futureshocked/NodeRed-ESP32-TerrariumController/KiCad Terrarium Controller project/node-red-terrarium-controller sch v2 original.pdf

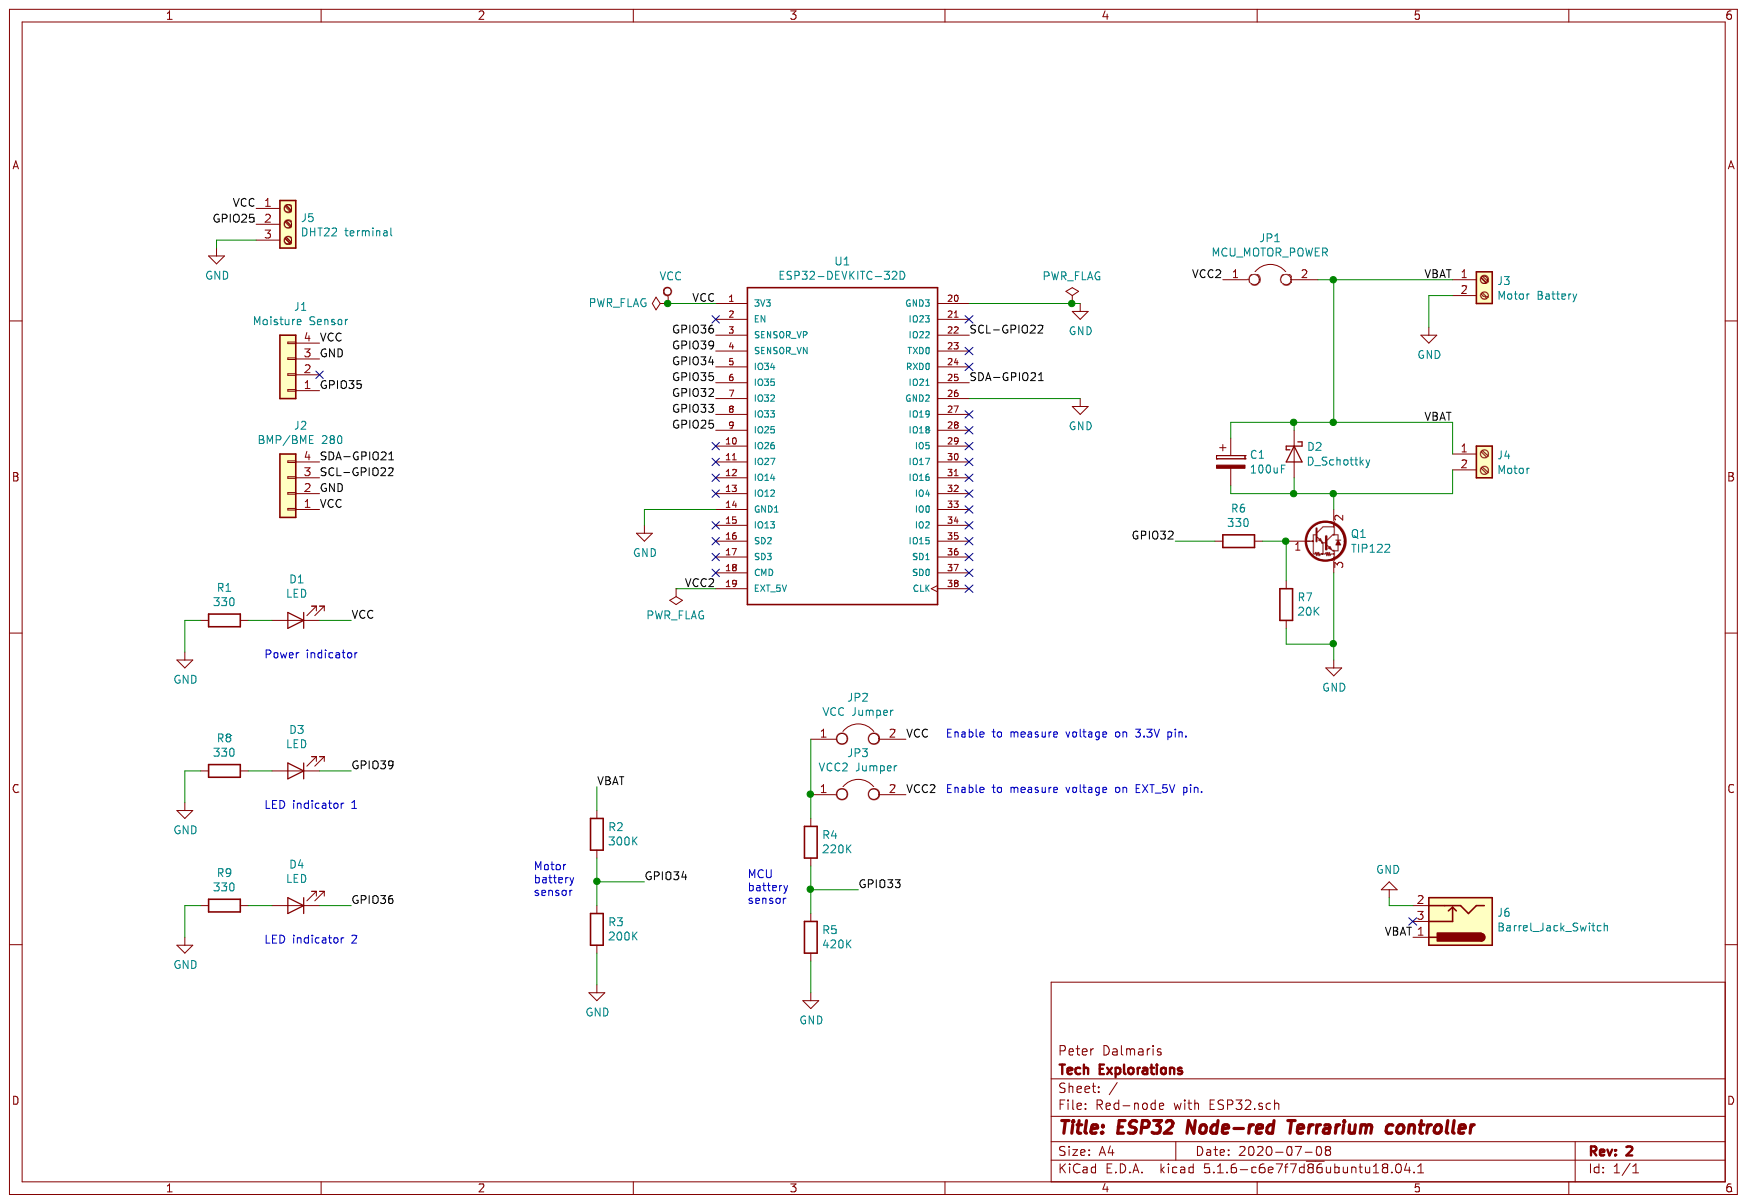
[picture p1: page 1]
