futureshocked/NodeRed-ESP32-TerrariumController/(list of files, drawings)

Other design files:
KiCad Terrarium Controller project/Red-node with ESP32.dsn
