futureshocked/NodeRed-ESP32-TerrariumController/KiCad Terrarium Controller project/Red-node with ESP32.kicad_pcb

## KiCad design KiCad Terrarium Controller project/Red-node with ESP32.kicad_pcb (2025-11-27)

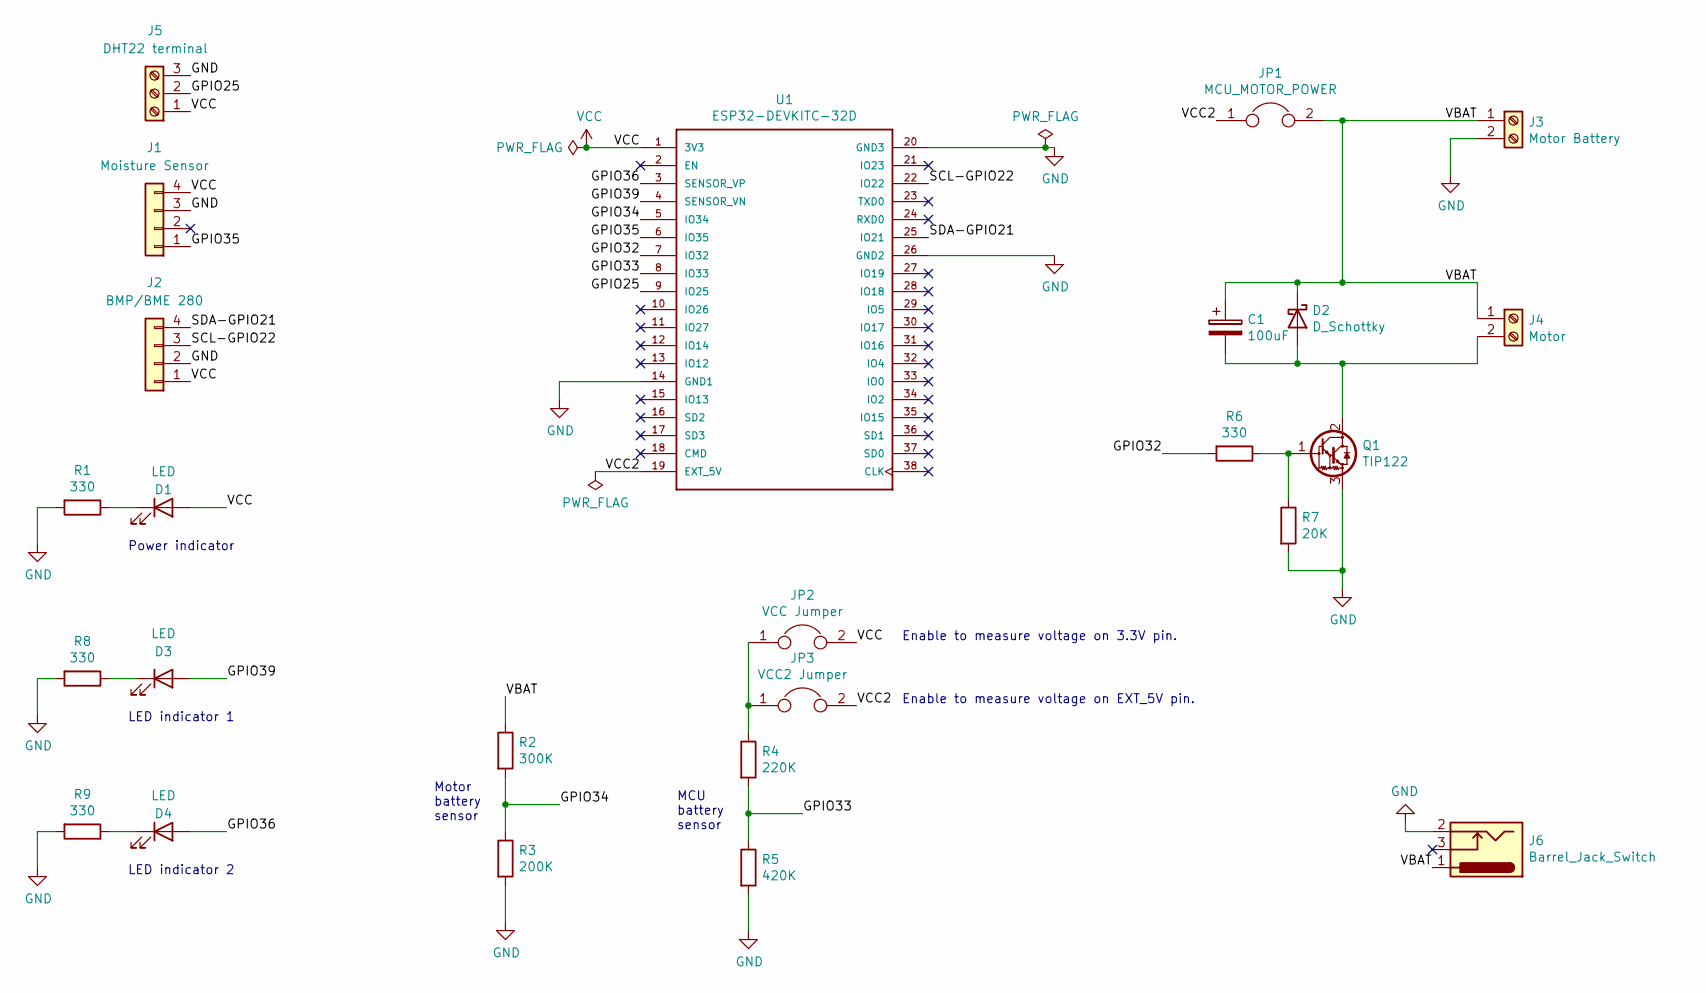
[picture p2: schematic Red-node with ESP32.kicad_sch, ESP32 Node-red Terrarium controller]

Parts:
C1: 100uF; CP_Radial_D8.0mm_P3.80mm
D1, D3, D4: LED; LED_D5.0mm
D2: D_Schottky; D_DO-41_SOD81_P7.62mm_Horizontal
J1: Moisture Sensor; PinHeader_1x04_P2.54mm_Vertical
J2: BMP/BME 280; PinHeader_1x04_P2.54mm_Vertical
J3: Motor Battery; TerminalBlock_bornier-2_P5.08mm
J4: Motor; TerminalBlock_bornier-2_P5.08mm
J5: DHT22 terminal; TerminalBlock_bornier-3_P5.08mm
J6: Barrel_Jack_Switch; BarrelJack_Horizontal
JP1: MCU_MOTOR_POWER; PinHeader_1x02_P2.54mm_Vertical
JP2: VCC Jumper; PinHeader_1x02_P2.54mm_Vertical
JP3: VCC2 Jumper; PinHeader_1x02_P2.54mm_Vertical
Q1: TIP122; TO-220-3_Vertical
R1, R6, R8, R9: 330; R_Axial_DIN0207_L6.3mm_D2.5mm_P7.62mm_Horizontal
R2: 300K; R_Axial_DIN0207_L6.3mm_D2.5mm_P7.62mm_Horizontal
R3: 200K; R_Axial_DIN0207_L6.3mm_D2.5mm_P7.62mm_Horizontal
R4: 220K; R_Axial_DIN0207_L6.3mm_D2.5mm_P7.62mm_Horizontal
R5: 420K; R_Axial_DIN0207_L6.3mm_D2.5mm_P7.62mm_Horizontal
R7: 20K; R_Axial_DIN0207_L6.3mm_D2.5mm_P7.62mm_Horizontal
U1: ESP32-DEVKITC-32D; MODULE_ESP32-DEVKITC_PD

Connections:
/GPIO25: J5.2, U1.9 (IO25)
/GPIO32: R6.2, U1.7 (IO32)
/GPIO33: R4.2, R5.1, U1.8 (IO33)
/GPIO34: R2.2, R3.1, U1.5 (IO34)
/GPIO35: J1.1, U1.6 (IO35)
/GPIO36: D4.2 (A), U1.3 (SENSOR_VP)
/GPIO39: D3.2 (A), U1.4 (SENSOR_VN)
/SCL-GPIO22: J2.3, U1.22 (IO22)
/SDA-GPIO21: J2.4, U1.25 (IO21)
/VBAT: C1.1, D2.1 (K), J3.1, J4.1, J6.1, JP1.2, R2.1
/VCC2: JP1.1, JP3.2, U1.19 (EXT_5V)
GND: J1.3, J2.2, J3.2, J5.3, J6.2, Q1.3 (E), R1.2, R3.2, R5.2, R7.2, R8.2, R9.2, U1.14 (GND1), U1.20 (GND3), U1.26 (GND2)
unnamed: D1.1 (K), R1.1
unnamed: C1.2, D2.2 (A), J4.2, Q1.2 (C)
unnamed: D3.1 (K), R8.1
unnamed: D4.1 (K), R9.1
unnamed: JP2.1, JP3.1, R4.1
unnamed: Q1.1 (B), R6.1, R7.1
VCC: D1.2 (A), J1.4, J2.1, J5.1, JP2.2, U1.1 (3V3)

Notes on the sheet:
LED indicator 2
Power indicator
Enable to measure voltage on EXT_5V pin.
Enable to measure voltage on 3.3V pin.
Motor battery sensor
LED indicator 1
MCU battery sensor

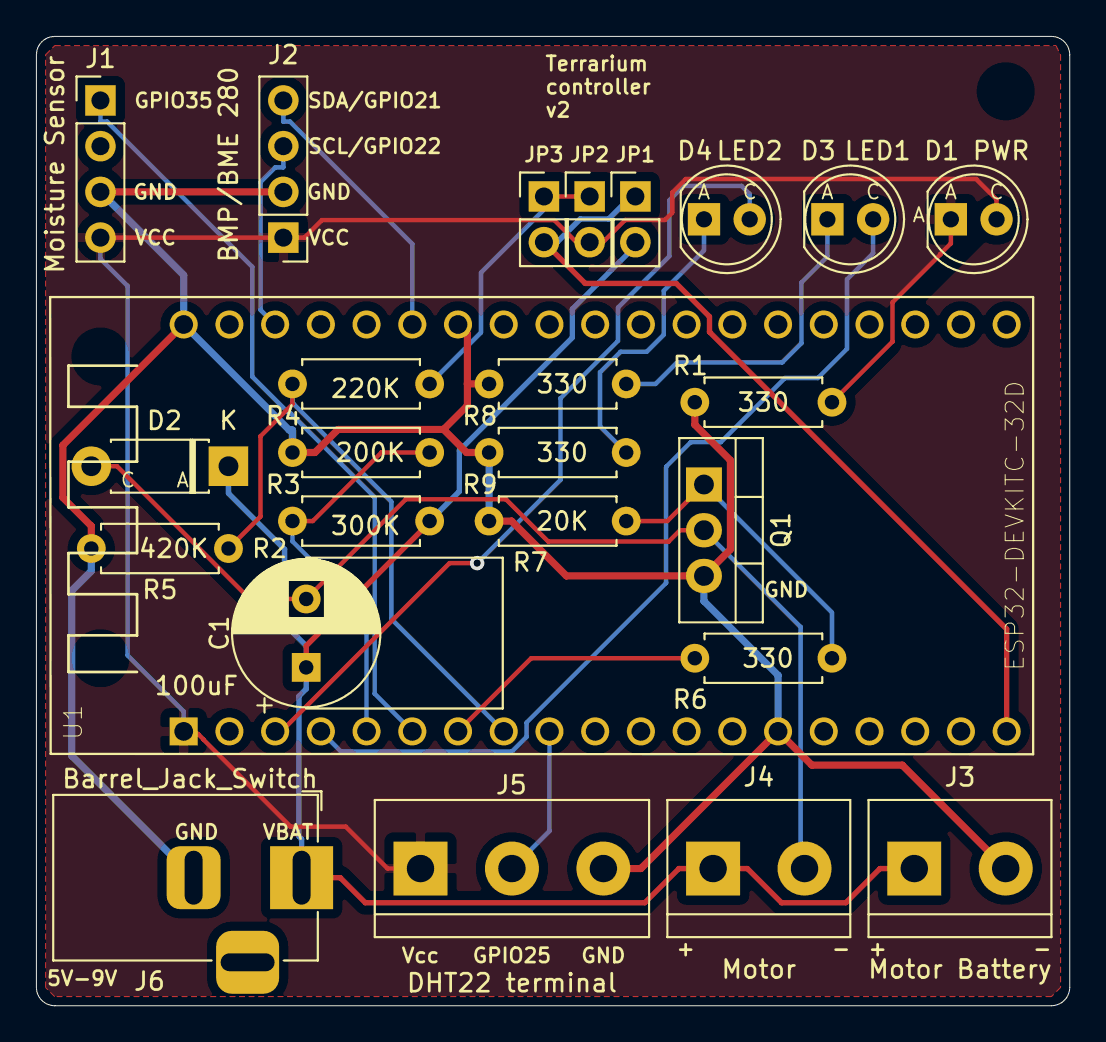
[picture p3: board Red-node with ESP32.kicad_pcb from above]

Board: 2 copper layers, 57.4 x 53.8 mm, 25 parts (0 on the bottom side), 19 nets.
