futureshocked/NodeRed-ESP32-TerrariumController/(commit log)

2020-07-24 New simple flow examples.
2025-11-26 Fixed incorrect LED orientation in the schematic
    [Red-node with ESP32.kicad_pcb, Red-node with ESP32.kicad_sch]
2025-11-27 Fixed issues with LED
    Both schematic and layouts are fixed.
    [Red-node with ESP32.kicad_pcb]
